tkurbad/Prometheus-Resurrector/(list of files, cad)

Other CAD files:
firmware/PCIH/isim/t_all_isim_beh.exe.sim/work/t_all_isim_beh.exe_main.nt.obj
firmware/PCIH/isim/precompiled.exe.sim/ieee/p_3620187407.nt.obj
firmware/PCIH/isim/t_all_isim_beh.exe.sim/unisim/p_0947159679.nt.obj
firmware/PCIH/isim/t_all_isim_beh.exe.sim/work/a_2474999364_2372691052.nt.obj
firmware/PCIH/isim/precompiled.exe.sim/ieee/p_1242562249.nt.obj
firmware/PCIH/isim/t_all_isim_beh.exe.sim/work/a_0537113747_3212880686.nt.obj
firmware/PCIH/isim/precompiled.exe.sim/ieee/p_3499444699.nt.obj
firmware/PCIH/isim/precompiled.exe.sim/ieee/p_2592010699.nt.obj
firmware/PCIH/isim/t_all_isim_beh.exe.sim/work/a_3490385537_3212880686.nt.obj
firmware/PCIH/isim/t_all_isim_beh.exe.sim/work/a_2380750733_3212880686.nt.obj
firmware/PCIH/isim/t_all_isim_beh.exe.sim/work/a_2995207169_3212880686.nt.obj
firmware/PCIH/isim/t_all_isim_beh.exe.sim/work/a_2259037628_3212880686.nt.obj
