tkurbad/Prometheus-Resurrector/hardware/KiCAD project/Prometheus.kicad_pcb

## KiCad design hardware/KiCAD project/Prometheus.kicad_pcb (2024-02-25)

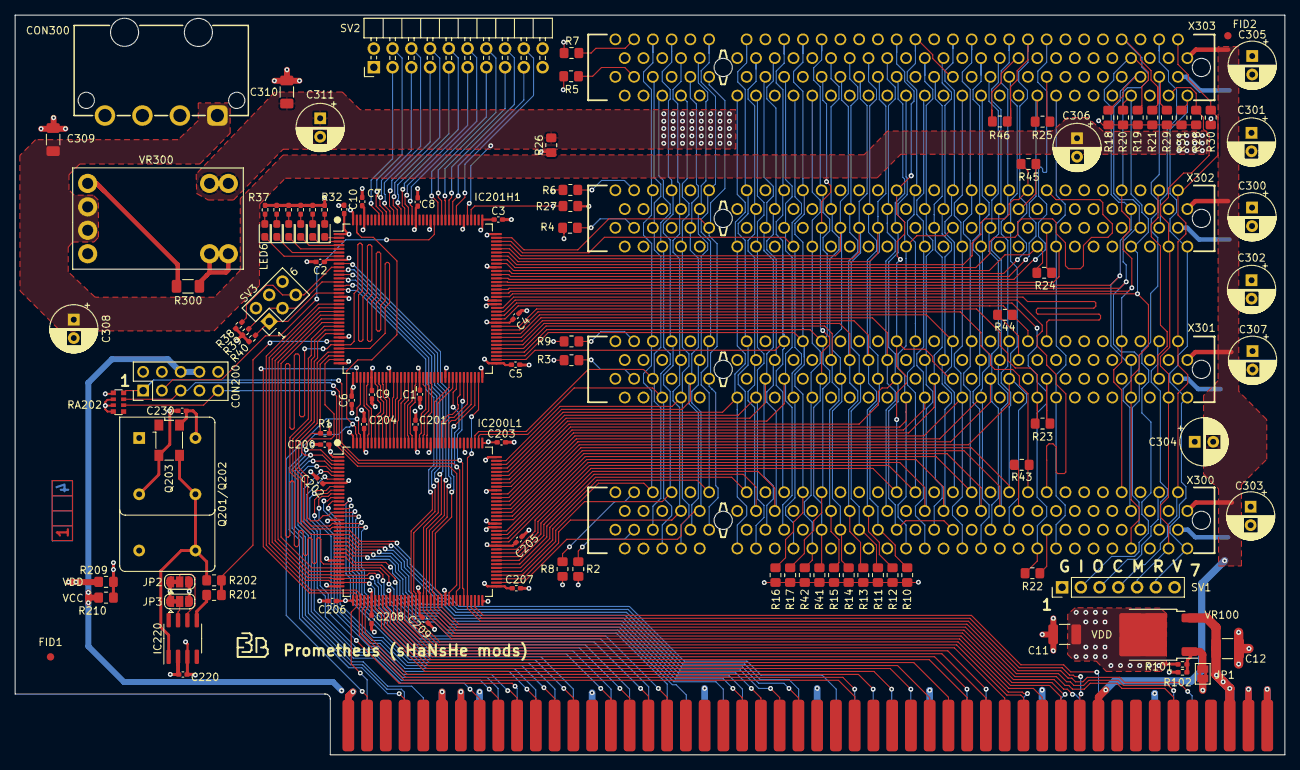
[picture p13: board Prometheus.kicad_pcb from above]

Board: 4 copper layers, 172.0 x 100.2 mm, 118 parts (0 on the bottom side), 208 nets.

Parts:
C1, C2, C3, C4, C5, C6, C7, C8, C9, C10, C200, C201, C202, C203, C204, C205, C206, C207, C208, C209, C220, C230: 100nF; C_0402_1005Metric_Pad0.74x0.62mm_HandSolder
C11, C12: 10uF Tantalum; C_1210_3225Metric_Pad1.33x2.70mm_HandSolder
C300, C301, C302, C303, C304, C305, C306, C307, C308, C311: 100uF; CP_Radial_D6.3mm_P2.50mm
C309, C310: 100nF; C_1206_3216Metric_Pad1.33x1.80mm_HandSolder
CON200: Conn_02x05_Odd_Even; PinHeader_2x05_P2.54mm_Vertical
CON300: Conn_01x04_Pin; TE-350211-MATE-N-LCK-RightAngle
FID1, FID2: Fiducial; Fiducial_1mm_Mask2mm
IC200L1, IC201H1: XC95144XL-TQ144; TQFP-144_20x20mm_P0.5mm
IC220: NB3N502; SOIC-8_3.9x4.9mm_P1.27mm
JP1: SolderJumper_2_Bridged; SolderJumper-2_P1.3mm_Bridged2Bar_Pad1.0x1.5mm
JP2, JP3: SolderJumper_3_Bridged12; SolderJumper-3_P1.3mm_Bridged12_RoundedPad1.0x1.5mm
LED1, LED2, LED3, LED4, LED5, LED6: LED; LED_0603_1608Metric_Pad1.05x0.95mm_HandSolder
Q201/Q202: 33MHz; Oscillator_DIP-14_DIP-8
Q203: 33MHz; Oscillator_SMD_Fordahl_DFAS15-4Pin_5.0x3.2mm
R1, R38, R39, R40: 4k7; R_0402_1005Metric_Pad0.72x0.64mm_HandSolder
R2, R3, R4, R5, R6, R7, R8, R9, R10, R11, R12, R13, R14, R15, R16, R17, R18, R19, R20, R21, R22, R23, R24, R25, R28, R29, R30, R31, R41, R42: 1k0; R_0805_2012Metric_Pad1.20x1.40mm_HandSolder
R26: 3k3; R_0805_2012Metric_Pad1.20x1.40mm_HandSolder
R27: 4k7; R_0805_2012Metric_Pad1.20x1.40mm_HandSolder
R32, R33, R34, R35, R36, R37: 680; R_0402_1005Metric_Pad0.72x0.64mm_HandSolder
R43, R44, R45, R46: 10k0; R_0805_2012Metric_Pad1.20x1.40mm_HandSolder
R101: 150; R_0402_1005Metric_Pad0.72x0.64mm_HandSolder
R102: 240; R_0402_1005Metric_Pad0.72x0.64mm_HandSolder
R201, R202: 15R; R_0805_2012Metric_Pad1.20x1.40mm_HandSolder
R209, R210: FerriteBead_Small; R_0805_2012Metric_Pad1.20x1.40mm_HandSolder
R300: 2k0; R_1206_3216Metric_Pad1.30x1.75mm_HandSolder
RA202: R_Pack04; R_Array_Convex_4x0612
SV1: Conn_01x07_Pin; PinHeader_1x07_P2.54mm_Vertical
SV2: Conn_02x10_Odd_Even; PinHeader_2x10_P2.54mm_Horizontal
SV3: Conn_02x03_Odd_Even; PinHeader_2x03_P2.54mm_Vertical
U1: Zorro3
VR100: AP1117-ADJ; TO-252-2
VR300: DCDC
X300, X301, X302, X303: Bus_PCI_32bit_5V; PCI

Connections:
+3V3: C310.1, C311.1, IC201H1.113, R26.2, VR300.6 (VOUT), X300.A21 (+3.3V), X300.A27 (+3.3V), X300.A33 (+3.3V), X300.A39 (+3.3V), X300.A45 (+3.3V), X300.A53 (+3.3V), X300.B25 (+3.3V), X300.B31 (+3.3V), X300.B36 (+3.3V), X300.B41 (+3.3V), X300.B43 (+3.3V), X300.B54 (+3.3V), X301.A21 (+3.3V), X301.A27 (+3.3V), X301.A33 (+3.3V), X301.A39 (+3.3V), X301.A45 (+3.3V), X301.A53 (+3.3V), X301.B25 (+3.3V), X301.B31 (+3.3V), X301.B36 (+3.3V), X301.B41 (+3.3V), X301.B43 (+3.3V), X301.B54 (+3.3V), X302.A21 (+3.3V), X302.A27 (+3.3V), X302.A33 (+3.3V), X302.A39 (+3.3V), X302.A45 (+3.3V), X302.A53 (+3.3V), X302.B25 (+3.3V), X302.B31 (+3.3V), X302.B36 (+3.3V), X302.B41 (+3.3V), X302.B43 (+3.3V), X302.B54 (+3.3V), X303.A21 (+3.3V), X303.A27 (+3.3V), X303.A33 (+3.3V), X303.A39 (+3.3V), X303.A45 (+3.3V), X303.A53 (+3.3V), X303.B25 (+3.3V), X303.B31 (+3.3V), X303.B36 (+3.3V), X303.B41 (+3.3V), X303.B43 (+3.3V), X303.B54 (+3.3V)
+5V: C300.1, C303.1, C305.1, C307.1, CON300.4, IC201H1.112, R2.1, R3.1, R4.1, R5.1, R6.2, R7.2, R8.2, R9.2, R10.2, R11.2, R12.2, R13.2, R14.2, R15.2, R16.2, R17.2, R18.2, R19.2, R20.2, R21.2, R22.2, R23.2, R24.2, R25.2, R27.2, R28.2, R29.2, R31.2, R41.2, R42.2, R43.2, R44.2, R45.2, R46.2, SV1.7, X300.A5 (+5V), X300.A8 (+5V), X300.A10 (+5V), X300.A16 (+5V), X300.A59 (+5V), X300.A61 (+5V), X300.A62 (+5V), X300.B5 (+5V), X300.B6 (+5V), X300.B19 (+5V), X300.B59 (+5V), X300.B61 (+5V), X300.B62 (+5V), X301.A5 (+5V), X301.A8 (+5V), X301.A10 (+5V), X301.A16 (+5V), X301.A59 (+5V), X301.A61 (+5V), X301.A62 (+5V), X301.B5 (+5V), X301.B6 (+5V), X301.B19 (+5V), X301.B59 (+5V), X301.B61 (+5V), X301.B62 (+5V), X302.A5 (+5V), X302.A8 (+5V), X302.A10 (+5V), X302.A16 (+5V), X302.A59 (+5V), X302.A61 (+5V), X302.A62 (+5V), X302.B5 (+5V), X302.B6 (+5V), X302.B19 (+5V), X302.B59 (+5V), X302.B61 (+5V), X302.B62 (+5V), X303.A5 (+5V), X303.A8 (+5V), X303.A10 (+5V), X303.A16 (+5V), X303.A59 (+5V), X303.A61 (+5V), X303.A62 (+5V), X303.B5 (+5V), X303.B6 (+5V), X303.B19 (+5V), X303.B59 (+5V), X303.B61 (+5V), X303.B62 (+5V)
+12V: C301.1, C302.1, C306.1, C308.1, C309.1, CON300.1, VR300.2 (TRACK), VR300.3 (VIN), X300.A2 (+12V), X301.A2 (+12V), X302.A2 (+12V), X303.A2 (+12V)
-12V: C304.2, U1.20 (-12VDC), X300.B1 (-12V), X301.B1 (-12V), X302.B1 (-12V), X303.B1 (-12V)
AD8: IC200L1.52, U1.30 (AD8)
AD9: IC200L1.50, U1.32 (AD9)
AD10: IC200L1.48, U1.34 (AD10)
AD11: IC200L1.46, U1.36 (AD11)
AD12: IC200L1.45, U1.38 (AD12)
AD13: IC200L1.44, U1.39 (AD13)
AD14: IC200L1.43, U1.41 (AD14)
AD15: IC200L1.41, U1.43 (AD15)
AD16: IC200L1.40, U1.45 (AD16)
AD17: IC200L1.21, U1.47 (AD17)
AD18: IC200L1.23, U1.52 (AD18)
AD19: IC200L1.24, U1.54 (AD19)
AD20: IC200L1.25, U1.56 (AD20)
AD21: IC200L1.27, U1.58 (AD21)
AD22: IC200L1.26, U1.57 (AD22)
AD23: IC200L1.28, U1.59 (AD23)
AD24: IC200L1.10, U1.80 (AD24)
AD25: IC200L1.12, U1.78 (AD25)
AD26: IC200L1.14, U1.76 (AD26)
AD27: IC200L1.17, U1.71 (AD27)
AD28: IC200L1.20, IC201H1.27, U1.69 (AD28)
AD29: IC200L1.34, IC201H1.22, U1.67 (AD29)
AD30: IC200L1.32 (I/O/GCK2), IC201H1.24, U1.65 (AD30)
AD31: IC200L1.31, IC201H1.25, U1.63 (AD31)
DEBUG0: IC201H1.116, SV2.18
DEBUG1: IC201H1.117, SV2.17
DEBUG2: IC201H1.118, SV2.16
DEBUG3: IC201H1.119, SV2.15
DEBUG4: IC201H1.120, SV2.14
DEBUG5: IC201H1.121, SV2.13
DEBUG6: IC201H1.128, SV2.12
DEBUG7: IC201H1.129, SV2.11
DEBUG8: IC201H1.130, SV2.10
DEBUG9: IC201H1.131, SV2.9
DEBUG10: IC201H1.132, SV2.8
DEBUG11: IC201H1.133, SV2.7
DEBUG12: IC201H1.134, SV2.6
DEBUG13: IC201H1.135, SV2.5
DEBUG14: IC201H1.136, SV2.4
DEBUG15: IC201H1.137, SV2.3
DOE: IC200L1.2 (I/O/GTS3), IC201H1.35, U1.93 (DOE)
FC0: IC200L1.51, U1.31 (FC0)
FC1: IC200L1.49, U1.33 (FC1)
GNDD: C1.2, C2.2, C3.2, C4.2, C5.2, C6.2, C7.2, C8.2, C9.2, C10.2, C11.2, C12.2, C200.2, C201.2, C202.2, C203.2, C204.2, C205.2, C206.2, C207.2, C208.2, C209.2, C220.2, C230.2, C300.2, C301.2, C302.2, C303.2, C304.1, C305.2, C306.2, C307.2, C308.2, C309.2, C310.2, C311.2, CON200.2, CON200.10, CON300.2, CON300.3, IC200L1.18 (GND), IC200L1.29 (GND), IC200L1.36 (GND), IC200L1.47 (GND), IC200L1.62 (GND), IC200L1.72 (GND), IC200L1.89 (GND), IC200L1.90 (GND), IC200L1.99 (GND), IC200L1.108 (GND), IC200L1.114 (GND), IC200L1.123 (GND), IC200L1.144 (GND), IC201H1.18 (GND), IC201H1.29 (GND), IC201H1.36 (GND), IC201H1.47 (GND), IC201H1.62 (GND), IC201H1.72 (GND), IC201H1.89 (GND), IC201H1.90 (GND), IC201H1.99 (GND), IC201H1.108 (GND), IC201H1.114 (GND), IC201H1.123 (GND), IC201H1.144 (GND), IC220.3 (GND), JP1.2 (B), JP2.1 (A), JP3.1 (A), Q201/Q202.4 (GND), Q201/Q202.7 (GND), Q203.2 (GND), R26.1, R27.1, R30.2, R102.2, R300.1, RA202.1 (R1.1), SV1.1, SV2.1, SV2.2, SV2.19, SV2.20, SV3.2, SV3.4, SV3.6, U1.1 (GND), U1.2 (GND), U1.3 (GND), U1.4 (GND), U1.13 (GND), U1.25 (GND), U1.37 (GND), U1.49 (GND), U1.61 (GND), U1.73 (GND), U1.85 (GND), U1.87 (GND), U1.88 (GND), U1.89 (GND), U1.90 (GND), U1.99 (GND), U1.100 (GND), VR300.1 (GND), X300.A12 (GND), X300.A13 (GND), X300.A18 (GND), X300.A24 (GND), X300.A30 (GND), X300.A35 (GND), X300.A37 (GND), X300.A42 (GND), X300.A48 (GND), X300.A56 (GND), X300.B3 (GND), X300.B12 (GND), X300.B13 (GND), X300.B15 (GND), X300.B17 (GND), X300.B22 (GND), X300.B28 (GND), X300.B34 (GND), X300.B38 (GND), X300.B46 (GND), X300.B49 (GND), X300.B57 (GND), X301.A12 (GND), X301.A13 (GND), X301.A18 (GND), X301.A24 (GND), X301.A30 (GND), X301.A35 (GND), X301.A37 (GND), X301.A42 (GND), X301.A48 (GND), X301.A56 (GND), X301.B3 (GND), X301.B12 (GND), X301.B13 (GND), X301.B15 (GND), X301.B17 (GND), X301.B22 (GND), X301.B28 (GND), X301.B34 (GND), X301.B38 (GND), X301.B46 (GND), X301.B49 (GND), X301.B57 (GND), X302.A12 (GND), X302.A13 (GND), X302.A18 (GND), X302.A24 (GND), X302.A30 (GND), X302.A35 (GND), X302.A37 (GND), X302.A42 (GND), X302.A48 (GND), X302.A56 (GND), X302.B3 (GND), X302.B12 (GND), X302.B13 (GND), X302.B15 (GND), X302.B17 (GND), X302.B22 (GND), X302.B28 (GND), X302.B34 (GND), X302.B38 (GND), X302.B46 (GND), X302.B49 (GND), X302.B57 (GND), X303.A12 (GND), X303.A13 (GND), X303.A18 (GND), X303.A24 (GND), X303.A30 (GND), X303.A35 (GND), X303.A37 (GND), X303.A42 (GND), X303.A48 (GND), X303.A56 (GND), X303.B3 (GND), X303.B12 (GND), X303.B13 (GND), X303.B15 (GND), X303.B17 (GND), X303.B22 (GND), X303.B28 (GND), X303.B34 (GND), X303.B38 (GND), X303.B46 (GND), X303.B49 (GND), X303.B57 (GND)
ICON0: IC200L1.140, IC201H1.40
ICON1: IC200L1.139, IC201H1.41
ICON2: IC200L1.138, IC201H1.43
ICON3: IC200L1.137, IC201H1.44
ICON4: IC200L1.136, IC201H1.45
ICON5: IC200L1.135, IC201H1.46
ICON6: IC200L1.134, IC201H1.48
ICON7: IC200L1.133, IC201H1.49
ICON8: IC200L1.132, IC201H1.50
ICON9: IC200L1.131, IC201H1.51
ICON10: IC200L1.130, IC201H1.52
ICON11: IC200L1.129, IC201H1.53
ICON12: IC200L1.128, IC201H1.54
ICON13: IC200L1.126, IC201H1.56
ICON14: IC200L1.125, IC201H1.57
ICON15: IC200L1.124, IC201H1.58
ICON16: IC200L1.121, IC201H1.64
ICON17: IC200L1.120, IC201H1.66
ICON18: IC200L1.119, IC201H1.68
ICON19: IC200L1.118, IC201H1.69
LED0: IC201H1.2 (I/O/GTS3), LED1.1 (K)
LED1: IC201H1.3 (I/O/GTS4), LED2.1 (K)
LED2: IC201H1.4, LED3.1 (K)
LED3: IC201H1.5 (I/O/GTS1), LED4.1 (K)
LED4: IC201H1.6 (I/O/GTS2), LED5.1 (K)
LED5: IC201H1.7, LED6.1 (K)
MASTERCLK: IC200L1.30 (I/O/GCK1), IC201H1.31, IC201H1.32 (I/O/GCK2)
unnamed: IC220.6 (S0), JP2.2 (C)
unnamed: IC220.7 (S1), JP3.2 (C)
unnamed: JP1.1 (A), R101.2, R102.1, VR100.1 (ADJ)
unnamed: LED1.2 (A), R32.1
unnamed: LED2.2 (A), R33.1
unnamed: LED3.2 (A), R34.1
unnamed: LED4.2 (A), R35.1
unnamed: LED5.2 (A), R36.1
unnamed: LED6.2 (A), R37.1
unnamed: R300.2, VR300.5 (VADJ)
unnamed: R8.1, X300.B60 (ACK64#)
unnamed: R2.2, X300.A60 (REQ64#)
unnamed: R9.1, X301.B60 (ACK64#)
unnamed: R3.2, X301.A60 (REQ64#)
unnamed: R6.1, X302.B60 (ACK64#)
unnamed: R4.2, X302.A60 (REQ64#)
unnamed: R7.1, X303.B60 (ACK64#)
unnamed: R5.2, X303.A60 (REQ64#)
OPT0: IC201H1.10, R38.1, SV3.5
OPT1: IC201H1.14, R39.1, SV3.3
OPT2: IC201H1.17, R40.1, SV3.1
P-AD0: IC200L1.111, X300.A58 (AD[00]), X301.A58 (AD[00]), X302.A58 (AD[00]), X303.A58 (AD[00])
P-AD1: IC200L1.77, X300.B58 (AD[01]), X301.B58 (AD[01]), X302.B58 (AD[01]), X303.B58 (AD[01])
P-AD2: IC200L1.110, X300.A57 (AD[02]), X301.A57 (AD[02]), X302.A57 (AD[02]), X303.A57 (AD[02])
P-AD3: IC200L1.76, X300.B56 (AD[03]), X301.B56 (AD[03]), X302.B56 (AD[03]), X303.B56 (AD[03])
P-AD4: IC200L1.107, X300.A55 (AD[04]), X301.A55 (AD[04]), X302.A55 (AD[04]), X303.A55 (AD[04])
P-AD5: IC200L1.75, X300.B55 (AD[05]), X301.B55 (AD[05]), X302.B55 (AD[05]), X303.B55 (AD[05])
P-AD6: IC200L1.106, X300.A54 (AD[06]), X301.A54 (AD[06]), X302.A54 (AD[06]), X303.A54 (AD[06])
P-AD7: IC200L1.74, X300.B53 (AD[07]), X301.B53 (AD[07]), X302.B53 (AD[07]), X303.B53 (AD[07])
P-AD8: IC200L1.78, X300.B52 (AD[08]), X301.B52 (AD[08]), X302.B52 (AD[08]), X303.B52 (AD[08])
P-AD9: IC200L1.105, X300.A49 (AD[09]), X301.A49 (AD[09]), X302.A49 (AD[09]), X303.A49 (AD[09])
P-AD10: IC200L1.79, X300.B48 (AD[10]), X301.B48 (AD[10]), X302.B48 (AD[10]), X303.B48 (AD[10])
P-AD11: IC200L1.104, X300.A47 (AD[11]), X301.A47 (AD[11]), X302.A47 (AD[11]), X303.A47 (AD[11])
P-AD12: IC200L1.80, X300.B47 (AD[12]), X301.B47 (AD[12]), X302.B47 (AD[12]), X303.B47 (AD[12])
P-AD13: IC200L1.103, X300.A46 (AD[13]), X301.A46 (AD[13]), X302.A46 (AD[13]), X303.A46 (AD[13])
P-AD14: IC200L1.81, X300.B45 (AD[14]), X301.B45 (AD[14]), X302.B45 (AD[14]), X303.B45 (AD[14])
P-AD15: IC200L1.102, X300.A44 (AD[15]), X301.A44 (AD[15]), X302.A44 (AD[15]), X303.A44 (AD[15])
P-AD16: IC200L1.101, X300.A26 (IDSEL), X300.A32 (AD[16]), X301.A32 (AD[16]), X302.A32 (AD[16]), X303.A32 (AD[16])
P-AD17: IC200L1.82, X300.B32 (AD[17]), X301.A26 (IDSEL), X301.B32 (AD[17]), X302.B32 (AD[17]), X303.B32 (AD[17])
P-AD18: IC200L1.100, X300.A31 (AD[18]), X301.A31 (AD[18]), X302.A26 (IDSEL), X302.A31 (AD[18]), X303.A31 (AD[18])
P-AD19: IC200L1.83, X300.B30 (AD[19]), X301.B30 (AD[19]), X302.B30 (AD[19]), X303.A26 (IDSEL), X303.B30 (AD[19])
P-AD20: IC200L1.98, X300.A29 (AD[20]), X301.A29 (AD[20]), X302.A29 (AD[20]), X303.A29 (AD[20])
P-AD21: IC200L1.85, X300.B29 (AD[21]), X301.B29 (AD[21]), X302.B29 (AD[21]), X303.B29 (AD[21])
P-AD22: IC200L1.97, X300.A28 (AD[22]), X301.A28 (AD[22]), X302.A28 (AD[22]), X303.A28 (AD[22])
P-AD23: IC200L1.86, X300.B27 (AD[23]), X301.B27 (AD[23]), X302.B27 (AD[23]), X303.B27 (AD[23])
P-AD24: IC200L1.96, X300.A25 (AD[24]), X301.A25 (AD[24]), X302.A25 (AD[24]), X303.A25 (AD[24])
P-AD25: IC200L1.87, X300.B24 (AD[25]), X301.B24 (AD[25]), X302.B24 (AD[25]), X303.B24 (AD[25])
P-AD26: IC200L1.95, X300.A23 (AD[26]), X301.A23 (AD[26]), X302.A23 (AD[26]), X303.A23 (AD[26])
P-AD27: IC200L1.88, X300.B23 (AD[27]), X301.B23 (AD[27]), X302.B23 (AD[27]), X303.B23 (AD[27])
P-AD28: IC200L1.94, X300.A22 (AD[28]), X301.A22 (AD[28]), X302.A22 (AD[28]), X303.A22 (AD[28])
P-AD29: IC200L1.91, X300.B21 (AD[29]), X301.B21 (AD[29]), X302.B21 (AD[29]), X303.B21 (AD[29])
P-AD30: IC200L1.93, X300.A20 (AD[30]), X301.A20 (AD[30]), X302.A20 (AD[30]), X303.A20 (AD[30])
P-AD31: IC200L1.92, X300.B20 (AD[31]), X301.B20 (AD[31]), X302.B20 (AD[31]), X303.B20 (AD[31])
P-CLK0: IC201H1.87, X300.B16 (CLK)
P-CLK1: IC201H1.88, X301.B16 (CLK)
P-CLK2: IC201H1.101, X302.B16 (CLK)
P-CLK3: IC201H1.96, X303.B16 (CLK)
P-PAR: IC201H1.106, X300.A43 (PAR), X301.A43 (PAR), X302.A43 (PAR), X303.A43 (PAR)
P-TCK: R30.1, SV1.4, X300.B2 (TCK), X301.B2 (TCK), X302.B2 (TCK), X303.B2 (TCK)
P-TD1: X302.A4 (TDI), X303.B4 (TDO)
P-TD2: X301.A4 (TDI), X302.B4 (TDO)
P-TD3: X300.A4 (TDI), X301.B4 (TDO)
P-TDI: R29.1, SV1.2, X303.A4 (TDI)
P-TDO: SV1.3, X300.B4 (TDO)
P-TMS: R28.1, SV1.5, X300.A3 (TMS), X301.A3 (TMS), X302.A3 (TMS), X303.A3 (TMS)
P-TRST: R31.1, SV1.6, X300.A1 (TRST#), X301.A1 (TRST#), X302.A1 (TRST#), X303.A1 (TRST#)
READ: IC200L1.35, IC201H1.21, U1.68 (READ)
SA2: IC200L1.54, IC201H1.15, U1.27 (A2)
SA3: IC200L1.56, IC201H1.13, U1.26 (A3)
SA4: IC200L1.57, IC201H1.12, U1.24 (A4)
SA5: IC200L1.59, IC201H1.9, U1.21 (A5)
SA6: IC200L1.58, IC201H1.11, U1.23 (A6)
SA7: IC200L1.53, IC201H1.16, U1.28 (A7)
SD0: IC200L1.15, U1.75 (SD0)
SD1: IC200L1.13, U1.77 (SD1)
SD2: IC200L1.11, U1.79 (SD2)
SD3: IC200L1.9, U1.81 (SD3)
SD4: IC200L1.6 (I/O/GTS2), U1.83 (SD4)
SD5: IC200L1.4, U1.86 (SD5)
SD6: IC200L1.5 (I/O/GTS1), U1.84 (SD6)
SD7: IC200L1.7, U1.82 (SD7)
SDONE: R41.1, X300.A40 (SDONE), X301.A40 (SDONE), X302.A40 (SDONE), X303.A40 (SDONE)
SENSEZ3: IC200L1.3 (I/O/GTS4), IC201H1.34, R1.2, U1.91 (SENSEZ3)
SYSCLK: IC201H1.30 (I/O/GCK1), R201.2, R202.2
SYSCLK_OSC: IC220.1 (X1/CLK), Q201/Q202.8 (OUT), Q201/Q202.11 (OUT), Q203.3 (OUT), R202.1
SYSCLK_PLL: IC220.5 (CLKOUT), R201.1
TCK: CON200.1, IC200L1.67 (TCK), IC201H1.67 (TCK), RA202.8 (R1.2)
TDI: CON200.9, IC200L1.63 (TDI), RA202.6 (R3.2)
TDO: CON200.3, IC201H1.122 (TDO)
TDO-TDI: IC200L1.122 (TDO), IC201H1.63 (TDI)
TMS: CON200.5, IC200L1.65 (TMS), IC201H1.65 (TMS), RA202.7 (R2.2)
VCC: C12.1, CON200.6, CON200.8, R210.1, U1.5 (+5VDC), U1.6 (+5VDC), VR100.3 (VI)
VDD: C1.1, C2.1, C3.1, C4.1, C5.1, C6.1, C7.1, C8.1, C9.1, C10.1, C11.1, C200.1, C201.1, C202.1, C203.1, C204.1, C205.1, C206.1, C207.1, C208.1, C209.1, CON200.4, IC200L1.1 (VCCIO), IC200L1.8 (VCCINT), IC200L1.37 (VCCIO), IC200L1.42 (VCCINT), IC200L1.55 (VCCIO), IC200L1.73 (VCCIO), IC200L1.84 (VCCINT), IC200L1.109 (VCCIO), IC200L1.127 (VCCIO), IC200L1.141 (VCCINT), IC201H1.1 (VCCIO), IC201H1.8 (VCCINT), IC201H1.37 (VCCIO), IC201H1.42 (VCCINT), IC201H1.55 (VCCIO), IC201H1.73 (VCCIO), IC201H1.84 (VCCINT), IC201H1.109 (VCCIO), IC201H1.127 (VCCIO), IC201H1.141 (VCCINT), R1.1, R32.2, R33.2, R34.2, R35.2, R36.2, R37.2, R38.2, R39.2, R40.2, R101.1, R209.1, RA202.2 (R2.1), RA202.3 (R3.1), RA202.4 (R4.1), VR100.2 (VO)
VPP: C220.1, C230.1, IC220.2 (VDD), JP2.3 (B), JP3.3 (B), Q201/Q202.14 (Vcc), Q203.4 (V+), R209.2, R210.2
~BERR: IC200L1.39, IC201H1.20, U1.46 (~BERR)
~CFGIN: IC200L1.60, U1.12 (~CFGINN)
~CFGOUT: IC200L1.61, IC201H1.70, U1.11 (~CFGOUTN)
~DS0: IC200L1.22, IC201H1.26, U1.51 (~DS0)
~DS1: IC200L1.142, IC201H1.39, U1.98 (~DS1)
~DS2: IC200L1.19, IC201H1.28, U1.70 (~DS2)
~DS3: IC200L1.16, IC201H1.33, U1.72 (~DS3)
~DTACK: IC200L1.33, IC201H1.23, U1.66 (~DTACK)
~FCS: IC200L1.38 (I/O/GCK3), IC201H1.38 (I/O/GCK3), U1.97 (~FCS)
~INT2: IC200L1.70, U1.19 (~INT2)
~INT6: IC200L1.69, U1.22 (~INT6)
~IORST: IC200L1.143 (I/O/GSR), IC201H1.143 (I/O/GSR), U1.94 (~IORST)
~P-CBE0: IC201H1.107, X300.A52 (C/BE#[0]), X301.A52 (C/BE#[0]), X302.A52 (C/BE#[0]), X303.A52 (C/BE#[0])
~P-CBE1: IC201H1.74, X300.B44 (C/BE#[1]), X301.B44 (C/BE#[1]), X302.B44 (C/BE#[1]), X303.B44 (C/BE#[1])
~P-CBE2: IC201H1.80, X300.B33 (C/BE#[2]), X301.B33 (C/BE#[2]), X302.B33 (C/BE#[2]), X303.B33 (C/BE#[2])
~P-CBE3: IC201H1.81, X300.B26 (C/BE#[3]), X301.B26 (C/BE#[3]), X302.B26 (C/BE#[3]), X303.B26 (C/BE#[3])
~P-DEVSEL: IC201H1.78, R13.1, X300.B37 (DEVSEL#), X301.B37 (DEVSEL#), X302.B37 (DEVSEL#), X303.B37 (DEVSEL#)
~P-FRAME: IC201H1.103, R10.1, X300.A34 (FRAME#), X301.A34 (FRAME#), X302.A34 (FRAME#), X303.A34 (FRAME#)
~P-GNT0: IC201H1.86, R22.1, X300.A17 (GNT#)
~P-GNT1: IC201H1.83, R23.1, X301.A17 (GNT#)
~P-GNT2: IC201H1.100, R24.1, X302.A17 (GNT#)
~P-GNT3: IC201H1.97, R25.1, X303.A17 (GNT#)
~P-INTA: IC201H1.93, R18.1, X300.A6 (INTA#), X301.A6 (INTA#), X302.A6 (INTA#), X303.A6 (INTA#)
~P-INTB: IC201H1.94, R19.1, X300.B7 (INTB#), X301.B7 (INTB#), X302.B7 (INTB#), X303.B7 (INTB#)
~P-INTC: IC201H1.91, R20.1, X300.A7 (INTC#), X301.A7 (INTC#), X302.A7 (INTC#), X303.A7 (INTC#)
~P-INTD: IC201H1.92, R21.1, X300.B8 (INTD#), X301.B8 (INTD#), X302.B8 (INTD#), X303.B8 (INTD#)
~P-IRDY: IC201H1.79, R12.1, X300.B35 (IRDY#), X301.B35 (IRDY#), X302.B35 (IRDY#), X303.B35 (IRDY#)
~P-LOCK: IC201H1.77, R15.1, X300.B39 (LOCK#), X301.B39 (LOCK#), X302.B39 (LOCK#), X303.B39 (LOCK#)
~P-PERR: IC201H1.76, R17.1, X300.B40 (PERR#), X301.B40 (PERR#), X302.B40 (PERR#), X303.B40 (PERR#)
~P-REQ0: IC201H1.82, R43.1, X300.B18 (REQ#)
~P-REQ1: IC201H1.85, R44.1, X301.B18 (REQ#)
~P-REQ2: IC201H1.102, R45.1, X302.B18 (REQ#)
~P-REQ3: IC201H1.98, R46.1, X303.B18 (REQ#)
~P-RST: IC201H1.95, X300.A15 (RST#), X301.A15 (RST#), X302.A15 (RST#), X303.A15 (RST#)
~P-SERR: IC201H1.75, R16.1, X300.B42 (SERR#), X301.B42 (SERR#), X302.B42 (SERR#), X303.B42 (SERR#)
~P-STOP: IC201H1.105, R14.1, X300.A38 (STOP#), X301.A38 (STOP#), X302.A38 (STOP#), X303.A38 (STOP#)
~P-TRDY: IC201H1.104, R11.1, X300.A36 (TRDY#), X301.A36 (TRDY#), X302.A36 (TRDY#), X303.A36 (TRDY#)
~SBO: R42.1, X300.A41 (SBO#), X301.A41 (SBO#), X302.A41 (SBO#), X303.A41 (SBO#)
~SLAVEN: IC200L1.68, IC201H1.71, U1.9 (~SLAVEN)
